Jnesselr/Vending-Machine/KiCad/MainBoard/Snack Machine.kicad_pcb

## KiCad design KiCad/MainBoard/Snack Machine.kicad_pcb (2020-05-02)

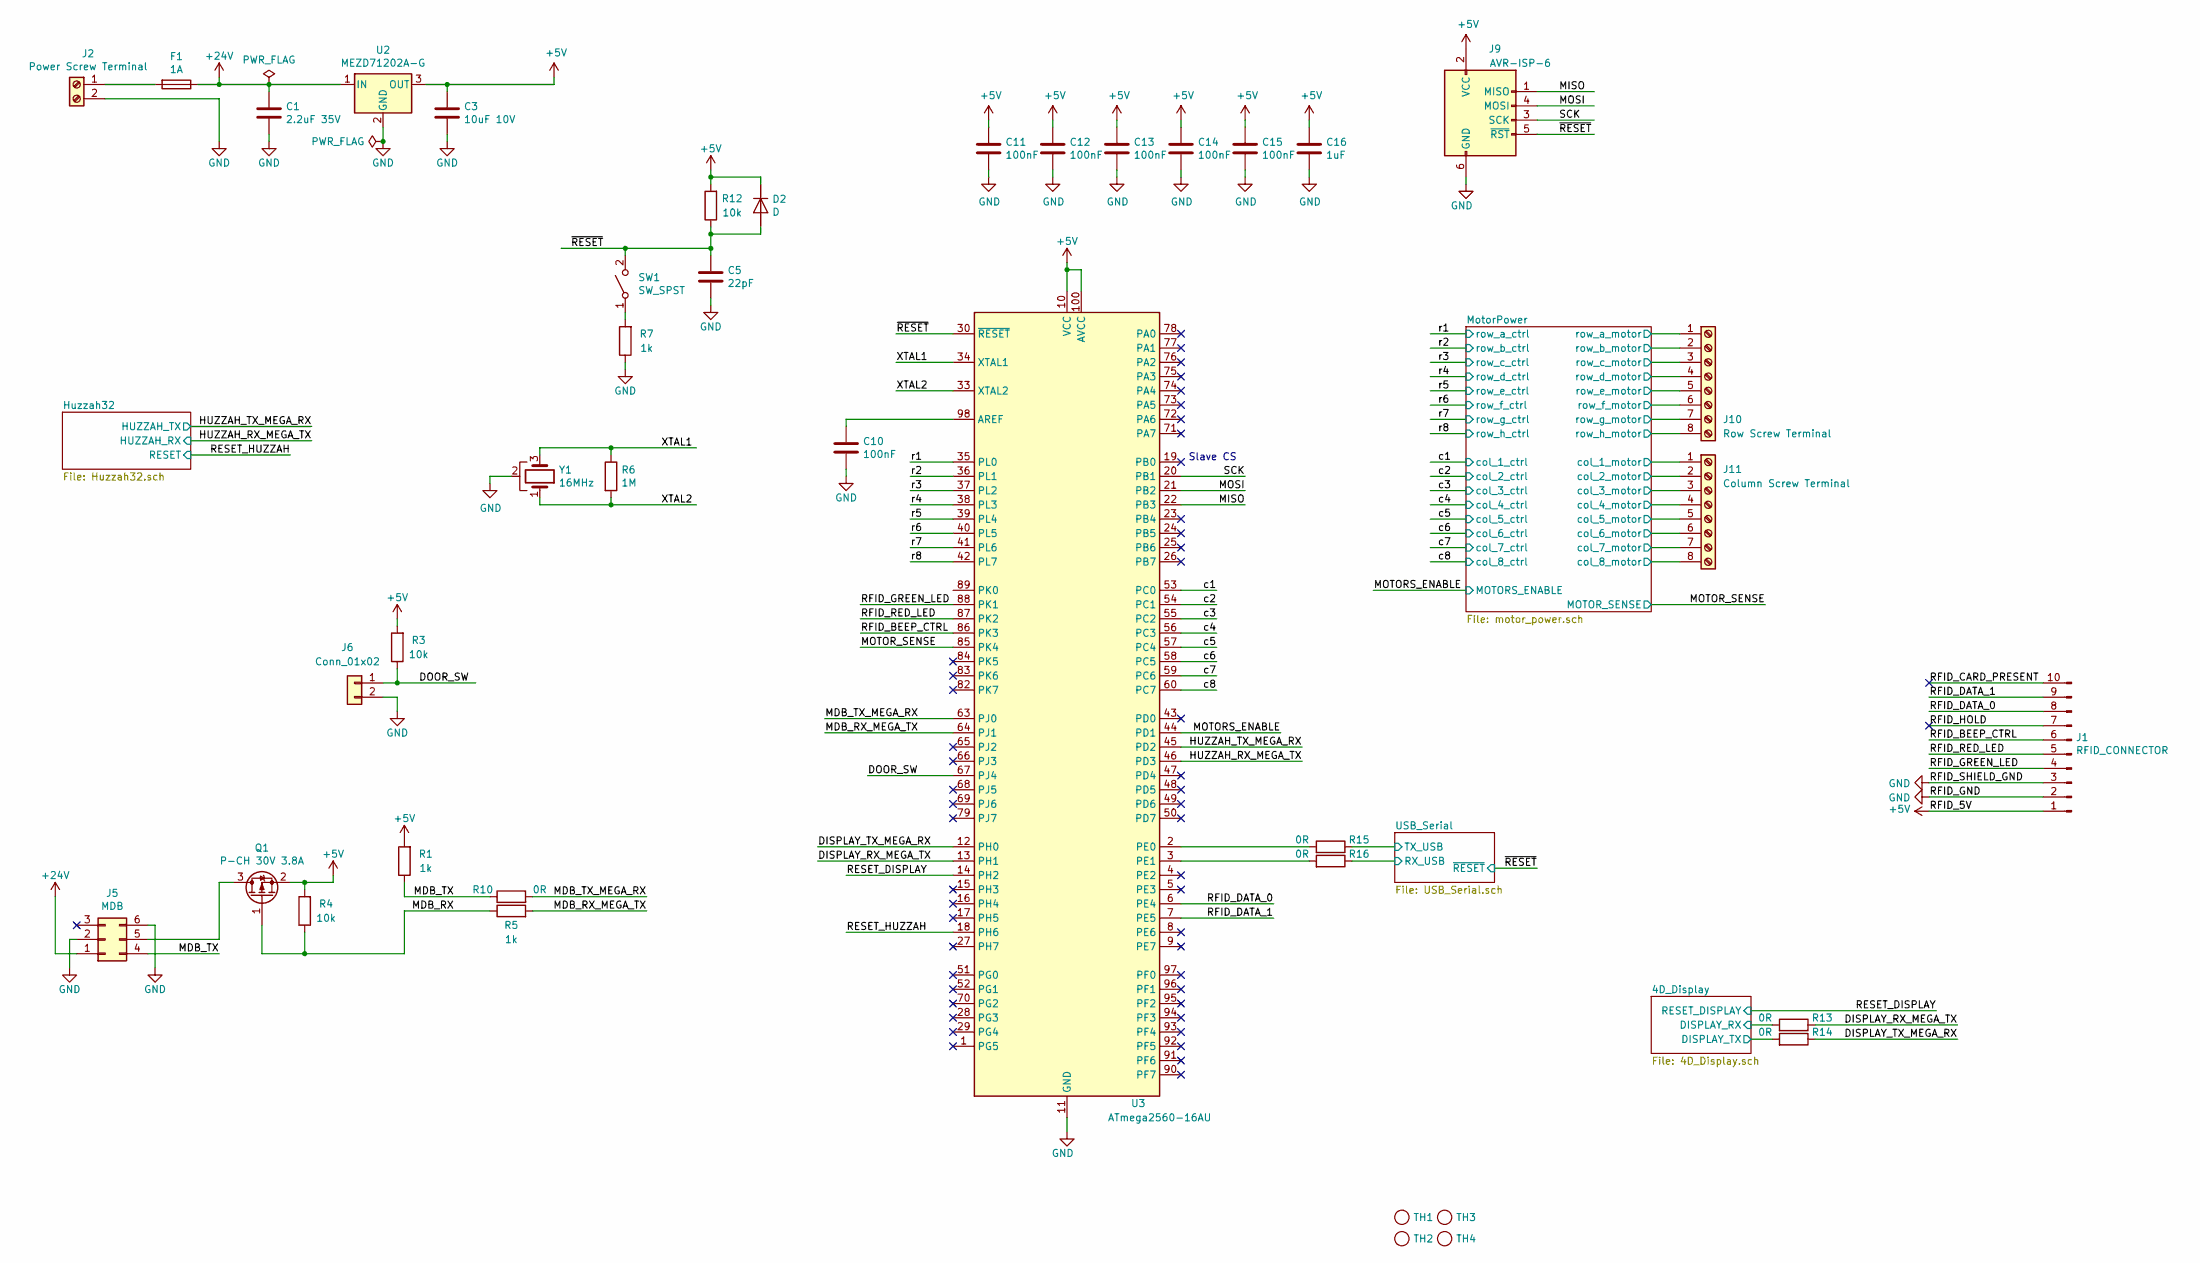
[picture p1: schematic Snack Machine.sch]

Parts:
C1: 2.2uF 35V; C_0805_2012Metric_Pad1.15x1.40mm_HandSolder; Part Number C2012JB1V225K125AB
C3: 10uF 10V; C_0603_1608Metric_Pad1.05x0.95mm_HandSolder; Part Number 0603ZD106KAT2A
C5: 22pF; C_0603_1608Metric_Pad1.05x0.95mm_HandSolder; Part Number C0603C220J1GACTU
C10, C11, C12, C13, C14, C15: 100nF; C_0603_1608Metric_Pad1.05x0.95mm_HandSolder; Part Number CC0603KRX7R9BB104
C16: 1uF; C_0603_1608Metric_Pad1.05x0.95mm_HandSolder; Part Number C1608X7R1A105K080AC
D2: D; D_1206_3216Metric_Pad1.42x1.75mm_HandSolder; Part Number CD1206-S01575
F1: 1A; Keystone_3544-2; Part Number 3544-2
J1: RFID_CONNECTOR; CONN_HEADER_VERT_10POS_2.54MM; Part Number 0705430009
J2: Power Screw Terminal; TerminalBlock_Phoenix_PT-1,5-2-5.0-H_1x02_P5.00mm_Horizontal; Part Number OQ0254500000G
J5: MDB; Molex_Mini-Fit_Jr_5566-06A_2x03_P4.20mm_Vertical; Part Number 0039290063
J6: Conn_01x02; CONN_HEADER_VERT_2POS_2.54MM; Part Number 0705430106
J9: AVR-ISP-6; PinHeader_2x03_P2.54mm_Vertical
J10: Row Screw Terminal; TerminalBlock_Phoenix_PT-1,5-8-5.0-H_1x08_P5.00mm_Horizontal; Part Number OQ0854500000G
J11: Column Screw Terminal; TerminalBlock_Phoenix_PT-1,5-8-5.0-H_1x08_P5.00mm_Horizontal; Part Number OQ0854500000G
Q1: P-CH 30V 3.8A; SOT-23_Handsoldering_Lite; Part Number DMP3099L-7
R1, R5, R7: 1k; R_0603_1608Metric_Pad1.05x0.95mm_HandSolder; Part Number RC0603FR-071KL
R3, R4, R12: 10k; R_0603_1608Metric_Pad1.05x0.95mm_HandSolder; Part Number RC0603FR-0710KL
R6: 1M; R_0603_1608Metric_Pad1.05x0.95mm_HandSolder; Part Number RC0603FR-071ML
R10, R13, R14, R15, R16: 0R; R_0603_1608Metric_Pad1.05x0.95mm_HandSolder; Part Number RC0603JR-070RL
SW1: SW_SPST; SW_SPST_FSMSM; Part Number FSMSM
TH1, TH2, TH3, TH4: tooling_hole; tooling_hole_2.55
U2: MEZD71202A-G; mEZD71201A
U3: ATmega2560-16AU; TQFP-100_14x14mm_P0.5mm
Y1: 16MHz; Resonator_SMD_ECS-CR2-16.00-B-TR; Part Number ECS-CR2-16.00-B-TR

Connections:
+5V: C3.1, C11.1, C12.1, C13.1, C14.1, C15.1, C16.1, D2.1 (K), J1.1, J9.2 (VCC), Q1.2 (S), R1.2, R3.2, R4.2, R12.2, U2.3 (OUT), U3.10 (VCC), U3.31 (VCC), U3.61 (VCC), U3.80 (VCC), U3.100 (AVCC); also elsewhere on the board
+24V: C1.1, F1.1, J5.1, U2.1 (IN); also elsewhere on the board
/4D_Display/DISPLAY_RX: R13.2; also elsewhere on the board
/4D_Display/DISPLAY_TX: R14.2; also elsewhere on the board
/DISPLAY_RX_MEGA_TX: R13.1, U3.13 (PH1)
/DISPLAY_TX_MEGA_RX: R14.1, U3.12 (PH0)
/DOOR_SW: J6.1, R3.1, U3.67 (PJ4)
/HUZZAH_RX_MEGA_TX: U3.46 (PD3); also elsewhere on the board
/HUZZAH_TX_MEGA_RX: U3.45 (PD2); also elsewhere on the board
/MDB_RX: Q1.1 (G), R4.1, R5.1
/MDB_RX_MEGA_TX: R5.2, U3.64 (PJ1)
/MDB_TX: J5.4, R1.1, R10.1
/MDB_TX_MEGA_RX: R10.2, U3.63 (PJ0)
/MISO: J9.1 (MISO), U3.22 (PB3)
/MOSI: J9.4 (MOSI), U3.21 (PB2)
/MOTORS_ENABLE: U3.44 (PD1); also elsewhere on the board
/MOTOR_SENSE: U3.85 (PK4); also elsewhere on the board
/MotorPower/col_1_motor: J11.1; also elsewhere on the board
/MotorPower/col_2_motor: J11.2; also elsewhere on the board
/MotorPower/col_3_motor: J11.3; also elsewhere on the board
/MotorPower/col_4_motor: J11.4; also elsewhere on the board
/MotorPower/col_5_motor: J11.5; also elsewhere on the board
/MotorPower/col_6_motor: J11.6; also elsewhere on the board
/MotorPower/col_7_motor: J11.7; also elsewhere on the board
/MotorPower/col_8_motor: J11.8; also elsewhere on the board
/MotorPower/row_a_motor: J10.1; also elsewhere on the board
/MotorPower/row_b_motor: J10.2; also elsewhere on the board
/MotorPower/row_c_motor: J10.3; also elsewhere on the board
/MotorPower/row_d_motor: J10.4; also elsewhere on the board
/MotorPower/row_e_motor: J10.5; also elsewhere on the board
/MotorPower/row_f_motor: J10.6; also elsewhere on the board
/MotorPower/row_g_motor: J10.7; also elsewhere on the board
/MotorPower/row_h_motor: J10.8; also elsewhere on the board
/RESET_DISPLAY: U3.14 (PH2); also elsewhere on the board
/RESET_HUZZAH: U3.18 (PH6); also elsewhere on the board
/RFID_BEEP_CTRL: J1.6, U3.86 (PK3)
/RFID_CARD_PRESENT: J1.10
/RFID_DATA_0: J1.8, U3.6 (PE4)
/RFID_DATA_1: J1.9, U3.7 (PE5)
/RFID_GREEN_LED: J1.4, U3.88 (PK1)
/RFID_HOLD: J1.7
/RFID_RED_LED: J1.5, U3.87 (PK2)
/SCK: J9.3 (SCK), U3.20 (PB1)
/USB_Serial/RX_USB: R16.1; also elsewhere on the board
/USB_Serial/TX_USB: R15.1; also elsewhere on the board
/XTAL1: R6.1, U3.34 (XTAL1), Y1.3
/XTAL2: R6.2, U3.33 (XTAL2), Y1.1
/c1: U3.53 (PC0); also elsewhere on the board
/c2: U3.54 (PC1); also elsewhere on the board
/c3: U3.55 (PC2); also elsewhere on the board
/c4: U3.56 (PC3); also elsewhere on the board
/c5: U3.57 (PC4); also elsewhere on the board
/c6: U3.58 (PC5); also elsewhere on the board
/c7: U3.59 (PC6); also elsewhere on the board
/c8: U3.60 (PC7); also elsewhere on the board
/r1: U3.35 (PL0); also elsewhere on the board
/r2: U3.36 (PL1); also elsewhere on the board
/r3: U3.37 (PL2); also elsewhere on the board
/r4: U3.38 (PL3); also elsewhere on the board
/r5: U3.39 (PL4); also elsewhere on the board
/r6: U3.40 (PL5); also elsewhere on the board
/r7: U3.41 (PL6); also elsewhere on the board
/r8: U3.42 (PL7); also elsewhere on the board
/~RESET: C5.1, D2.2 (A), J9.5 (~RST), R12.1, SW1.2 (B), U3.30 (~RESET); also elsewhere on the board
GND: C1.2, C3.2, C5.2, C10.2, C11.2, C12.2, C13.2, C14.2, C15.2, C16.2, J1.2, J1.3, J2.2, J5.2, J5.6, J6.2, J9.6 (GND), R7.1, U2.2 (GND), U3.11 (GND), U3.32 (GND), U3.62 (GND), U3.81 (GND), U3.99 (GND), Y1.2; also elsewhere on the board
unnamed: C10.1, U3.98 (AREF)
unnamed: F1.2, J2.1
unnamed: J5.5, Q1.3 (D)
unnamed: R7.2, SW1.1 (A)
unnamed: R15.2, U3.2 (PE0)
unnamed: R16.2, U3.3 (PE1)

Notes on the sheet:
Slave CS

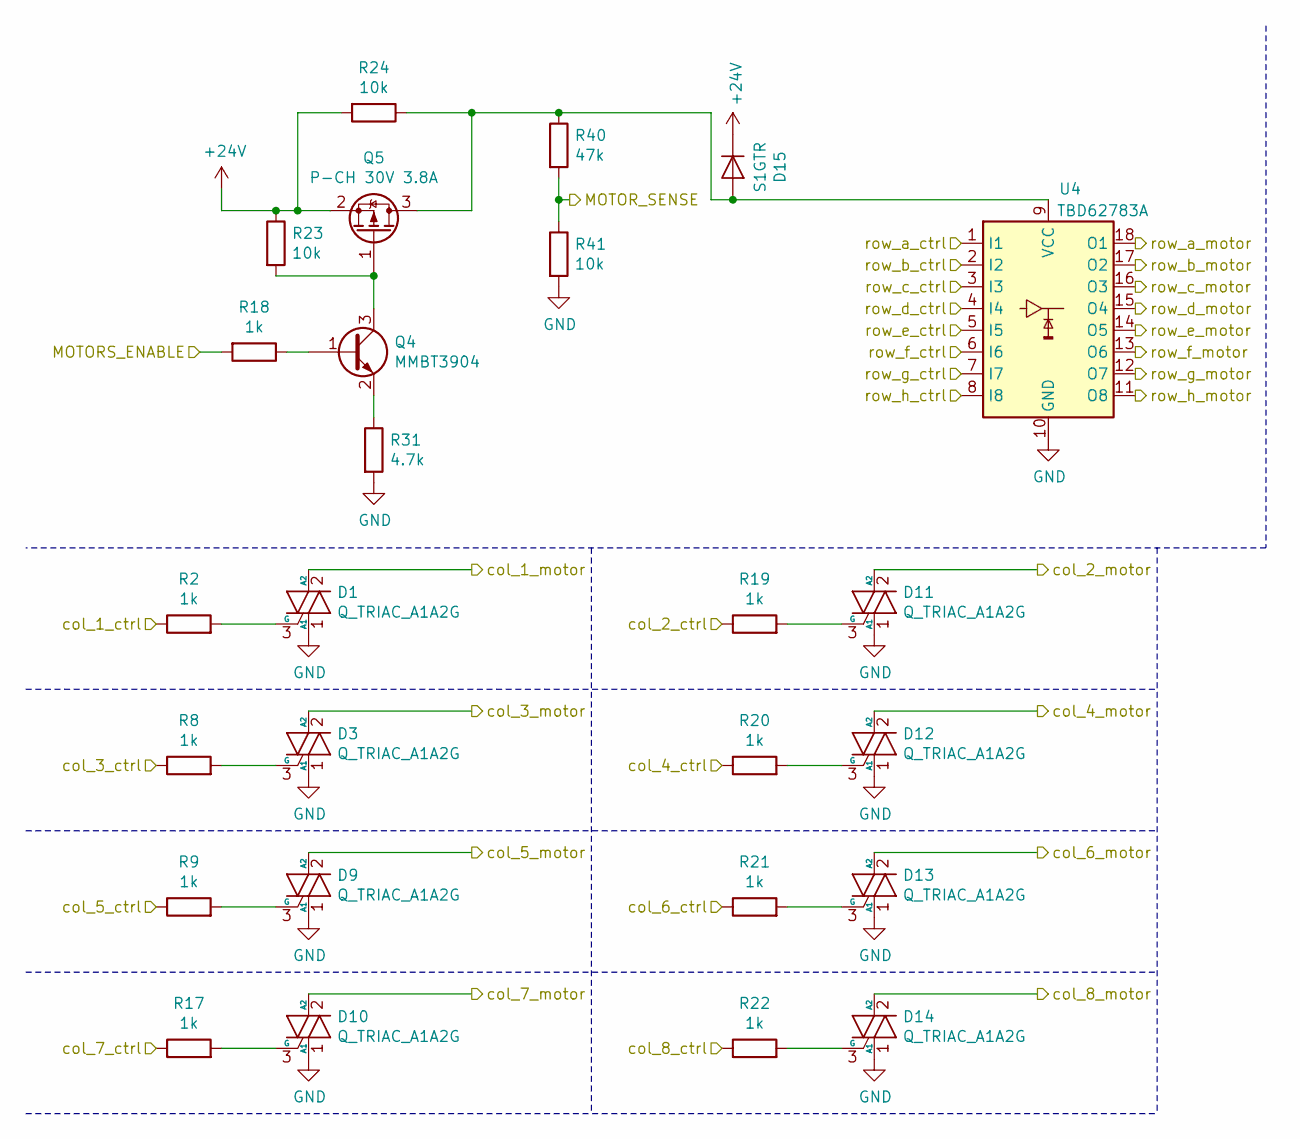
[picture p2: schematic motor_power.sch]

Parts:
D1, D3, D9, D10, D11, D12, D13, D14: Q_TRIAC_A1A2G; SOT-223-3_TabPin2; Part Number Z0103MN,135
D15: S1GTR; D_SMA_Handsoldering; Part Number S1GTR
Q4: MMBT3904; SOT-23_Handsoldering_Lite; Part Number MMBT3904-TP
Q5: P-CH 30V 3.8A; SOT-23_Handsoldering_Lite; Part Number DMP3099L-7
R2, R8, R9, R17, R18, R19, R20, R21, R22: 1k; R_0603_1608Metric_Pad1.05x0.95mm_HandSolder; Part Number RC0603FR-071KL
R23, R24, R41: 10k; R_0603_1608Metric_Pad1.05x0.95mm_HandSolder; Part Number RC0603FR-0710KL
R31: 4.7k; R_0603_1608Metric_Pad1.05x0.95mm_HandSolder; Part Number RC0603FR-074K7L
R40: 47k; R_0603_1608Metric_Pad1.05x0.95mm_HandSolder; Part Number RC0603FR-0747KL
U4: TBD62783A; SSOP-18_4.4x6.5mm_P0.65mm; Part Number TBD62783AFNG,EL

Connections:
+24V: D15.1 (K), Q5.2 (S), R23.1, R24.2; also elsewhere on the board
/MOTORS_ENABLE: R18.2; also elsewhere on the board
/MOTOR_SENSE: R40.2, R41.1; also elsewhere on the board
/MotorPower/col_1_motor: D1.2 (A2); also elsewhere on the board
/MotorPower/col_2_motor: D11.2 (A2); also elsewhere on the board
/MotorPower/col_3_motor: D3.2 (A2); also elsewhere on the board
/MotorPower/col_4_motor: D12.2 (A2); also elsewhere on the board
/MotorPower/col_5_motor: D9.2 (A2); also elsewhere on the board
/MotorPower/col_6_motor: D13.2 (A2); also elsewhere on the board
/MotorPower/col_7_motor: D10.2 (A2); also elsewhere on the board
/MotorPower/col_8_motor: D14.2 (A2); also elsewhere on the board
/MotorPower/row_a_motor: U4.18 (O1); also elsewhere on the board
/MotorPower/row_b_motor: U4.17 (O2); also elsewhere on the board
/MotorPower/row_c_motor: U4.16 (O3); also elsewhere on the board
/MotorPower/row_d_motor: U4.15 (O4); also elsewhere on the board
/MotorPower/row_e_motor: U4.14 (O5); also elsewhere on the board
/MotorPower/row_f_motor: U4.13 (O6); also elsewhere on the board
/MotorPower/row_g_motor: U4.12 (O7); also elsewhere on the board
/MotorPower/row_h_motor: U4.11 (O8); also elsewhere on the board
/c1: R2.1; also elsewhere on the board
/c2: R19.1; also elsewhere on the board
/c3: R8.1; also elsewhere on the board
/c4: R20.1; also elsewhere on the board
/c5: R9.1; also elsewhere on the board
/c6: R21.1; also elsewhere on the board
/c7: R17.1; also elsewhere on the board
/c8: R22.1; also elsewhere on the board
/r1: U4.1 (I1); also elsewhere on the board
/r2: U4.2 (I2); also elsewhere on the board
/r3: U4.3 (I3); also elsewhere on the board
/r4: U4.4 (I4); also elsewhere on the board
/r5: U4.5 (I5); also elsewhere on the board
/r6: U4.6 (I6); also elsewhere on the board
/r7: U4.7 (I7); also elsewhere on the board
/r8: U4.8 (I8); also elsewhere on the board
GND: D1.1 (A1), D3.1 (A1), D9.1 (A1), D10.1 (A1), D11.1 (A1), D12.1 (A1), D13.1 (A1), D14.1 (A1), R31.2, R41.2, U4.10 (GND); also elsewhere on the board
unnamed: D1.3 (G), R2.2
unnamed: D3.3 (G), R8.2
unnamed: D9.3 (G), R9.2
unnamed: D10.3 (G), R17.2
unnamed: D11.3 (G), R19.2
unnamed: D12.3 (G), R20.2
unnamed: D13.3 (G), R21.2
unnamed: D14.3 (G), R22.2
unnamed: D15.2 (A), Q5.3 (D), R24.1, R40.1, U4.9 (VCC)
unnamed: Q4.1 (B), R18.1
unnamed: Q4.2 (E), R31.1
unnamed: Q4.3 (C), Q5.1 (G), R23.2

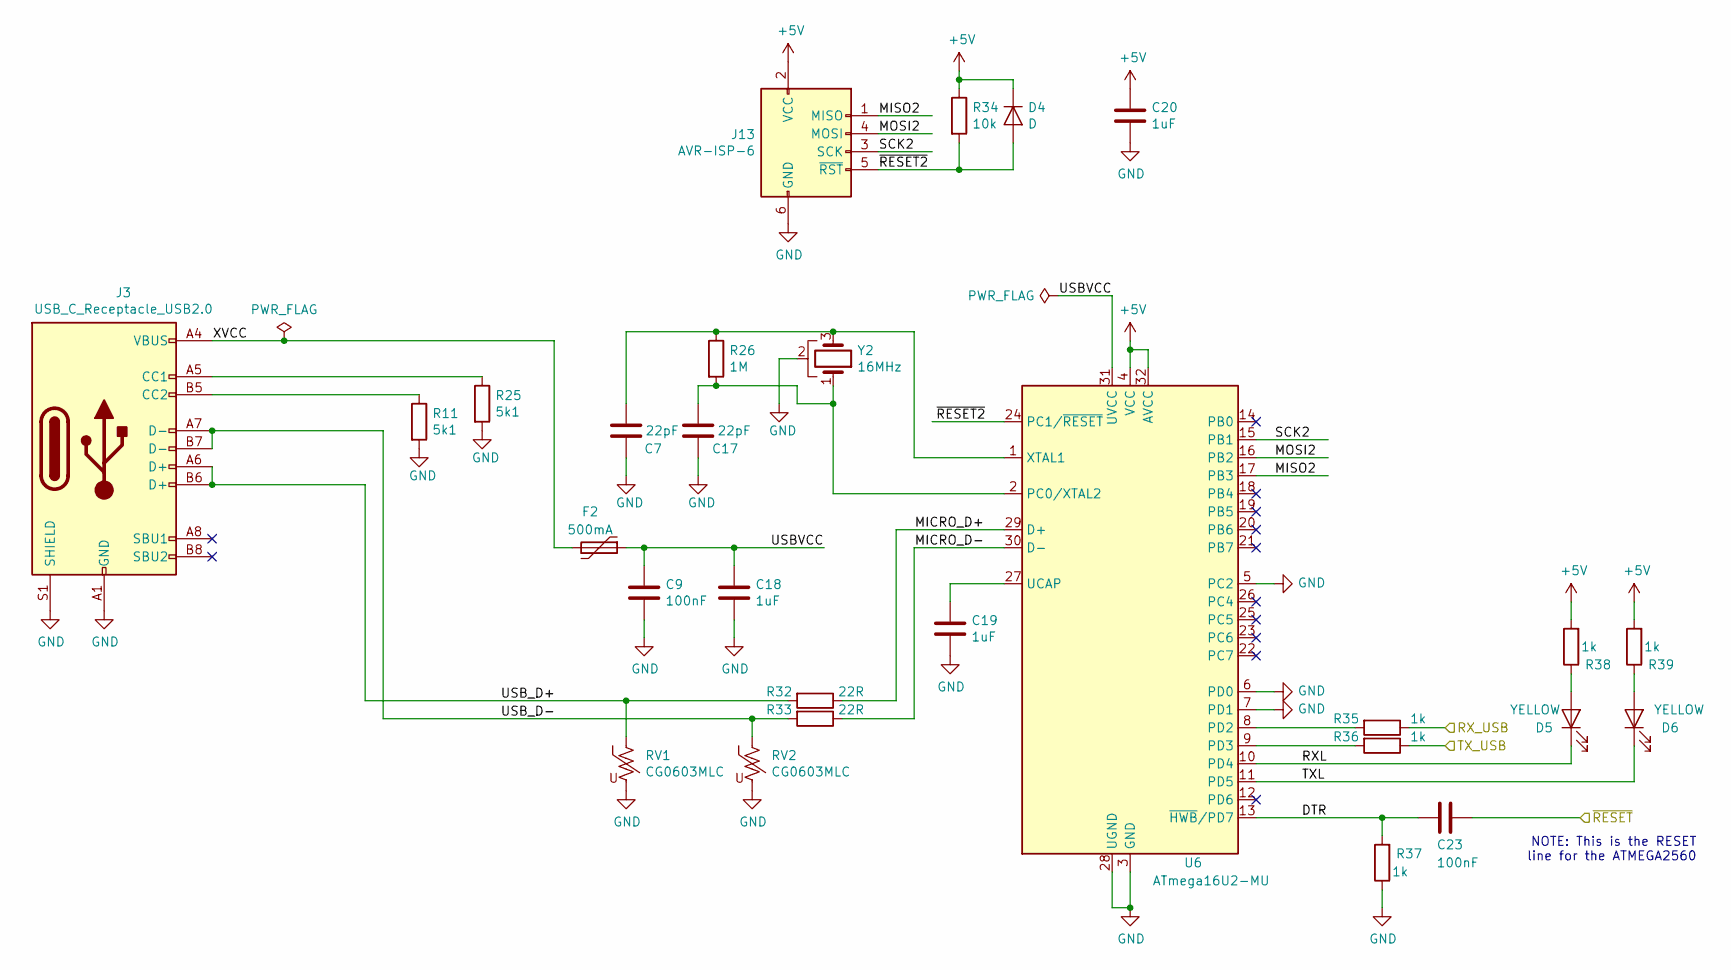
[picture p3: schematic USB_Serial.sch]

Parts:
C7, C17: 22pF; C_0603_1608Metric_Pad1.05x0.95mm_HandSolder; Part Number C0603C220J1GACTU
C9, C23: 100nF; C_0603_1608Metric_Pad1.05x0.95mm_HandSolder; Part Number CC0603KRX7R9BB104
C18, C19, C20: 1uF; C_0603_1608Metric_Pad1.05x0.95mm_HandSolder; Part Number C1608X7R1A105K080AC
D4: D; D_1206_3216Metric_Pad1.42x1.75mm_HandSolder; Part Number CD1206-S01575
D5, D6: YELLOW; LED_0603_1608Metric_Pad1.05x0.95mm_HandSolder; Part Number 150060YS75000
F2: 500mA; MF-MSMF050-2; Part Number MF-MSMF050-2
J3: USB_C_Receptacle_USB2.0; USB_C_Receptacle_HRO_TYPE-C-31-M-12; Part Number DX07S016JA1R1500
J13: AVR-ISP-6; PinHeader_2x03_P2.54mm_Vertical
R11, R25: 5k1; R_0603_1608Metric_Pad1.05x0.95mm_HandSolder; Part Number RC0603FR-075K1L
R26: 1M; R_0603_1608Metric_Pad1.05x0.95mm_HandSolder; Part Number RC0603FR-071ML
R32, R33: 22R; R_0603_1608Metric_Pad1.05x0.95mm_HandSolder; Part Number RC0603FR-0722RL
R34: 10k; R_0603_1608Metric_Pad1.05x0.95mm_HandSolder; Part Number RC0603FR-0710KL
R35, R36, R37, R38, R39: 1k; R_0603_1608Metric_Pad1.05x0.95mm_HandSolder; Part Number RC0603FR-071KL
RV1, RV2: CG0603MLC; R_0603_1608Metric_Pad1.05x0.95mm_HandSolder; Part Number CG0603MLC-05E
U6: ATmega16U2-MU; QFN-32-1EP_5x5mm_P0.5mm_EP3.1x3.1mm
Y2: 16MHz; Resonator_SMD_ECS-CR2-16.00-B-TR; Part Number ECS-CR2-16.00-B-TR

Connections:
+5V: C20.1, D4.1 (K), J13.2 (VCC), R34.1, R38.2, R39.2, U6.4 (VCC), U6.32 (AVCC); also elsewhere on the board
/USB_Serial/DTR: C23.2, R37.2, U6.13 (~HWB~/PD7)
/USB_Serial/MICRO_D+: R32.1, U6.29 (D+)
/USB_Serial/MICRO_D-: R33.1, U6.30 (D-)
/USB_Serial/MISO2: J13.1 (MISO), U6.17 (PB3)
/USB_Serial/MOSI2: J13.4 (MOSI), U6.16 (PB2)
/USB_Serial/RXL: D5.1 (K), U6.10 (PD4)
/USB_Serial/RX_USB: R35.1; also elsewhere on the board
/USB_Serial/SCK2: J13.3 (SCK), U6.15 (PB1)
/USB_Serial/TXL: D6.1 (K), U6.11 (PD5)
/USB_Serial/TX_USB: R36.1; also elsewhere on the board
/USB_Serial/USBVCC: C9.1, C18.1, F2.1, U6.31 (UVCC)
/USB_Serial/USB_D+: J3.A6 (D+), J3.B6 (D+), R32.2, RV1.1
/USB_Serial/USB_D-: J3.A7 (D-), J3.B7 (D-), R33.2, RV2.1
/USB_Serial/XVCC: F2.2, J3.A4 (VBUS), J3.B4 (VBUS)
/USB_Serial/~RESET2: D4.2 (A), J13.5 (~RST), R34.2, U6.24 (PC1/~RESET)
/~RESET: C23.1; also elsewhere on the board
GND: C7.1, C9.2, C17.1, C18.2, C19.2, C20.2, J3.A1 (GND), J3.B1 (GND), J3.S1 (SHIELD), J13.6 (GND), R11.2, R25.2, R37.1, RV1.2, RV2.2, U6.3 (GND), U6.5 (PC2), U6.6 (PD0), U6.7 (PD1), U6.28 (UGND), U6.33 (GND), Y2.2; also elsewhere on the board
unnamed: C7.2, R26.1, U6.1 (XTAL1), Y2.3
unnamed: C17.2, R26.2, U6.2 (PC0/XTAL2), Y2.1
unnamed: C19.1, U6.27 (UCAP)
unnamed: D5.2 (A), R38.1
unnamed: D6.2 (A), R39.1
unnamed: J3.A5 (CC1), R25.1
unnamed: J3.B5 (CC2), R11.1
unnamed: R35.2, U6.8 (PD2)
unnamed: R36.2, U6.9 (PD3)

Notes on the sheet:
NOTE: This is the RESET line for the ATMEGA2560

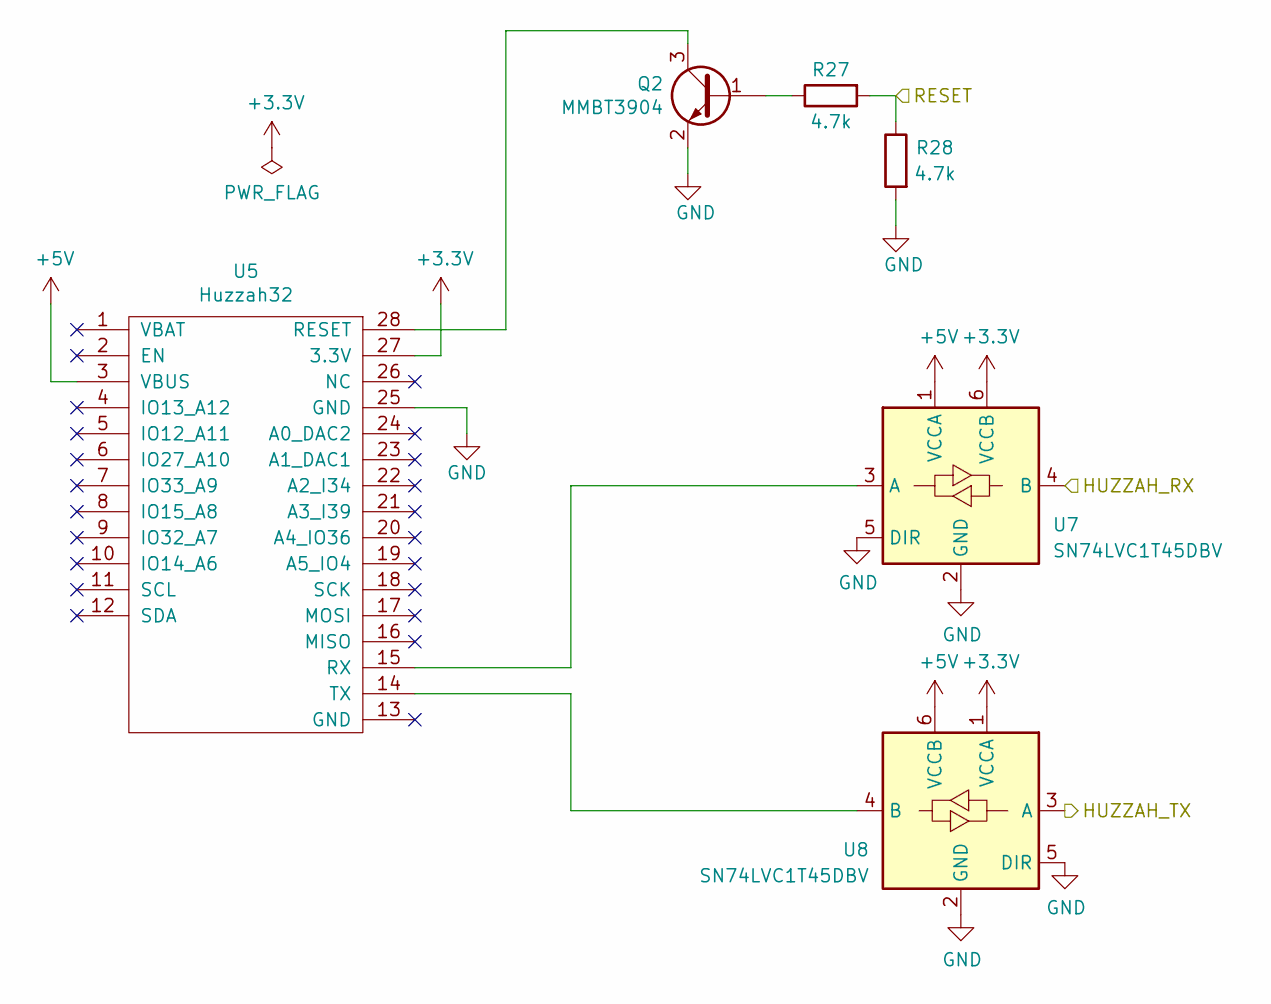
[picture p4: schematic Huzzah32.sch]

Parts:
Q2: MMBT3904; SOT-23_Handsoldering_Lite; Part Number MMBT3904-TP
R27, R28: 4.7k; R_0603_1608Metric_Pad1.05x0.95mm_HandSolder; Part Number RC0603FR-074K7L
U5: Huzzah32; HUZZAH32
U7, U8: SN74LVC1T45DBV; SOT-23-6; Part Number SN74LVC1T45DBV

Connections:
+3V3: U5.27 (3.3V), U7.6 (VCCB), U8.1 (VCCA)
+5V: U5.3 (VBUS), U7.1 (VCCA), U8.6 (VCCB); also elsewhere on the board
/HUZZAH_RX_MEGA_TX: U7.4 (B); also elsewhere on the board
/HUZZAH_TX_MEGA_RX: U8.3 (A); also elsewhere on the board
/RESET_HUZZAH: R27.2, R28.1; also elsewhere on the board
GND: Q2.2 (E), R28.2, U5.25 (GND), U7.2 (GND), U7.5 (DIR), U8.2 (GND), U8.5 (DIR); also elsewhere on the board
unnamed: Q2.1 (B), R27.1
unnamed: Q2.3 (C), U5.28 (RESET)
unnamed: U5.14 (TX), U8.4 (B)
unnamed: U5.15 (RX), U7.3 (A)

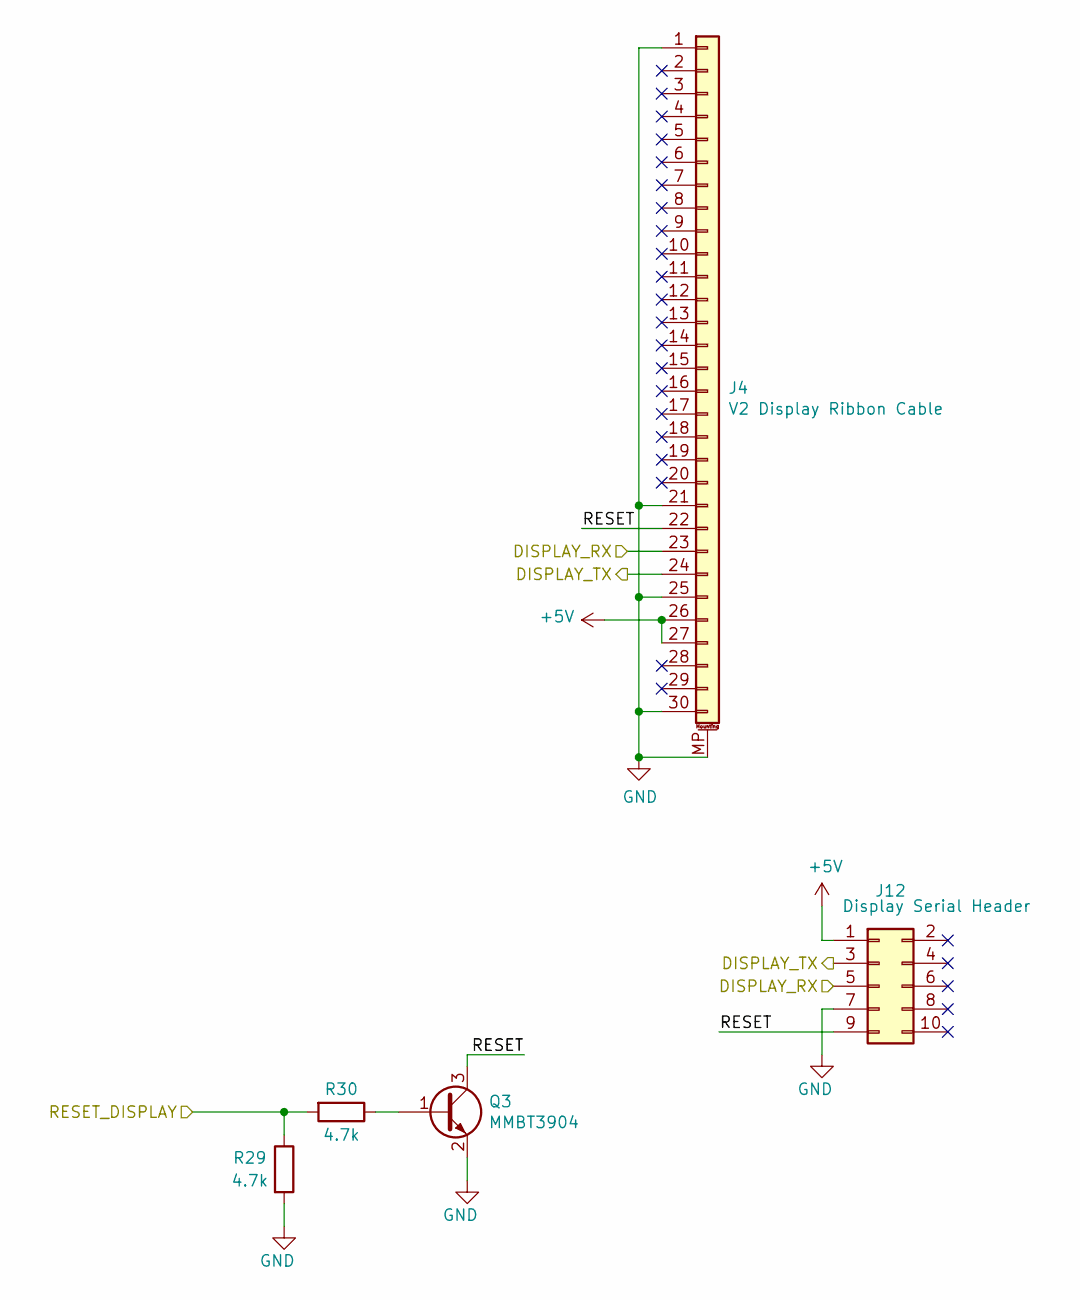
[picture p5: schematic 4D_Display.sch]

Parts:
J4: V2 Display Ribbon Cable; FPC30; Part Number 3-1734839-0
J12: Display Serial Header; PinHeader_2x05_P2.54mm_Vertical; Part Number 5103308-1
Q3: MMBT3904; SOT-23_Handsoldering_Lite; Part Number MMBT3904-TP
R29, R30: 4.7k; R_0603_1608Metric_Pad1.05x0.95mm_HandSolder; Part Number RC0603FR-074K7L

Connections:
+5V: J4.26, J4.27, J12.1; also elsewhere on the board
/4D_Display/DISPLAY_RX: J4.23, J12.5; also elsewhere on the board
/4D_Display/DISPLAY_TX: J4.24, J12.3; also elsewhere on the board
/4D_Display/RESET: J4.22, J12.9, Q3.3 (C)
/RESET_DISPLAY: R29.1, R30.2; also elsewhere on the board
GND: J4.1, J4.21, J4.25, J4.30, J4.MP (MountPin), J12.7, Q3.2 (E), R29.2; also elsewhere on the board
unnamed: Q3.1 (B), R30.1

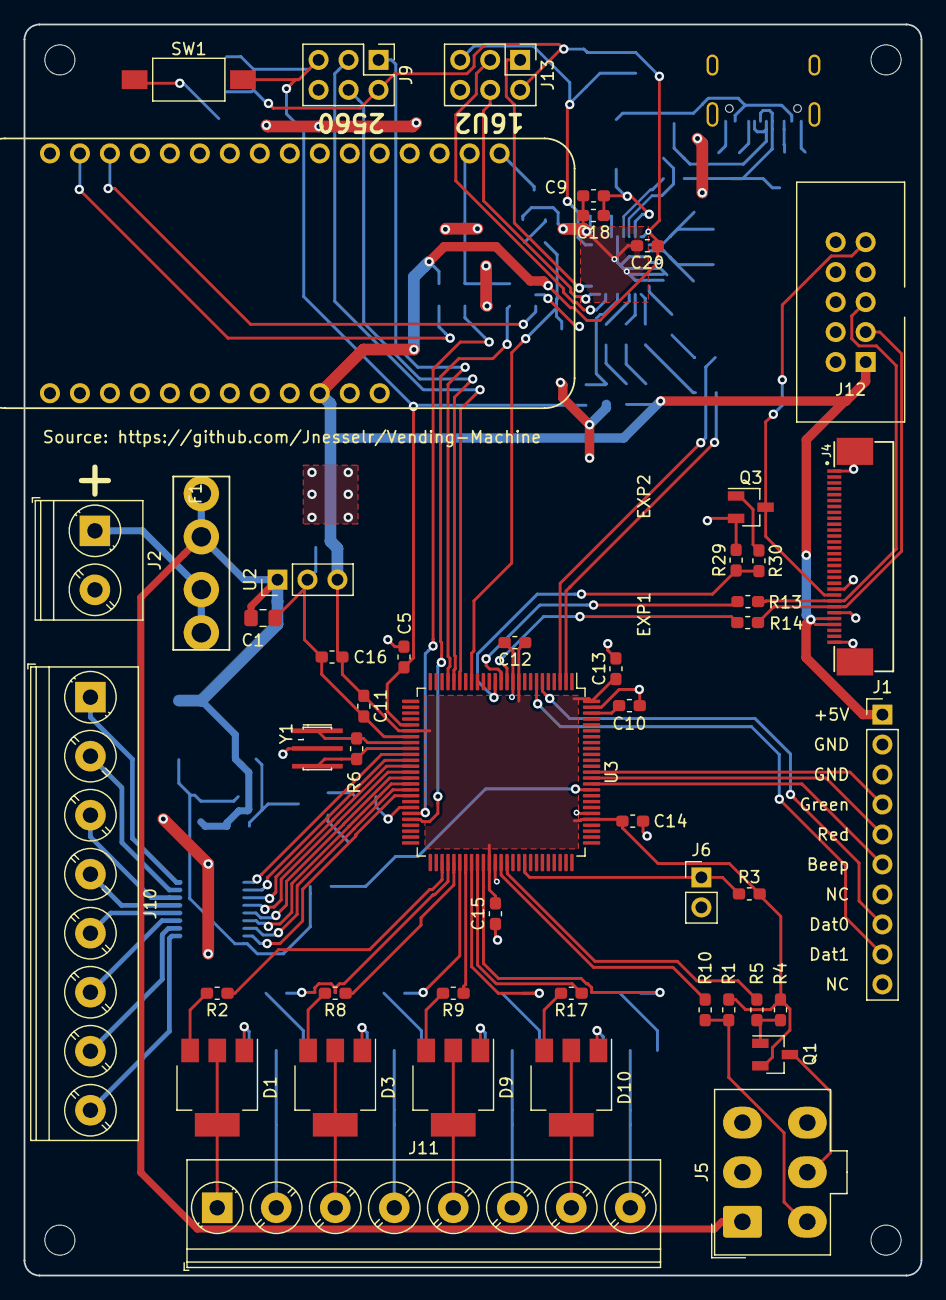
[picture p6: board Snack Machine.kicad_pcb from above]

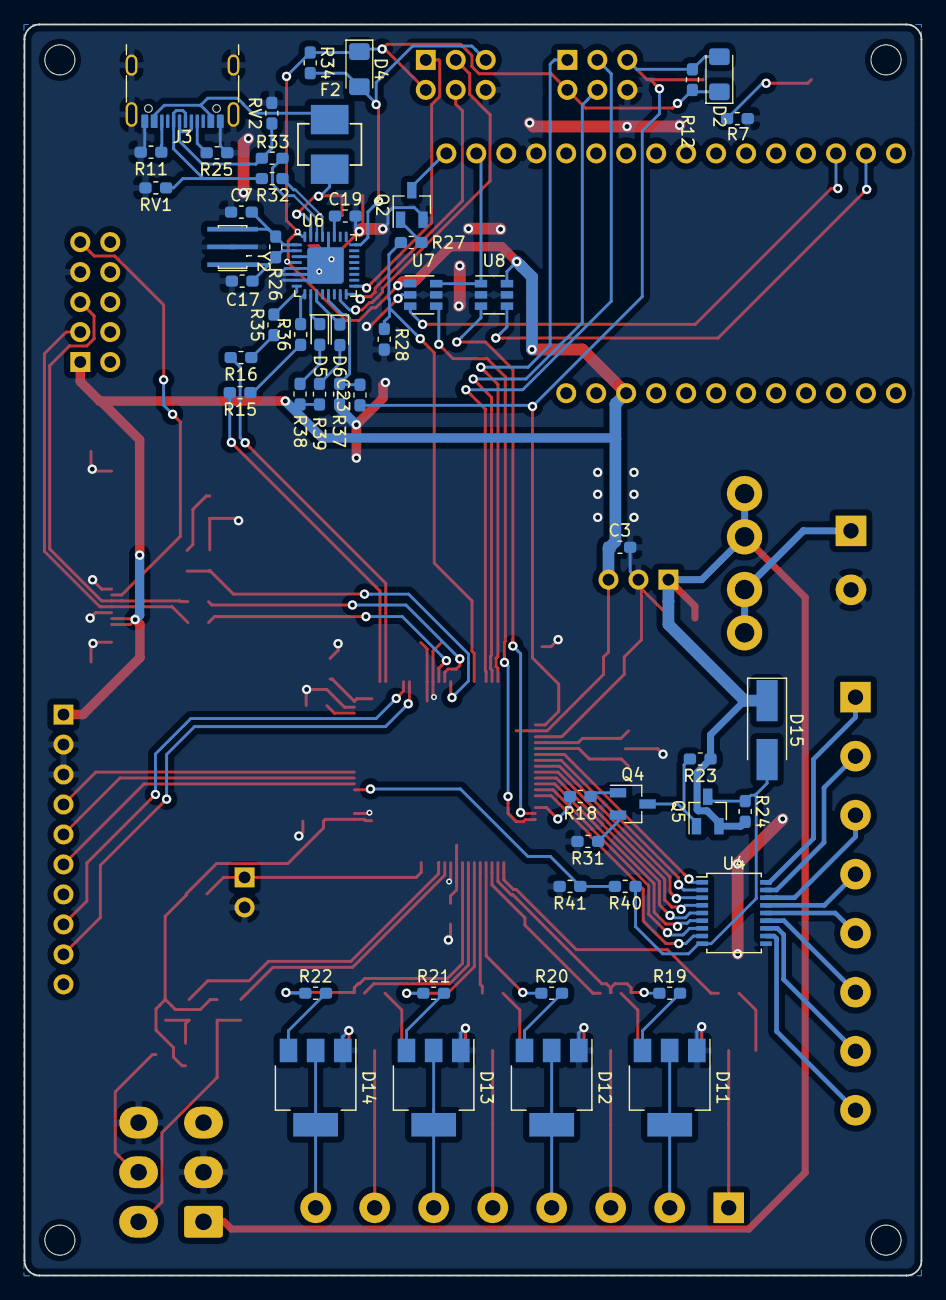
[picture p7: board Snack Machine.kicad_pcb from below]

Board: 2 copper layers, 76.0 x 106.0 mm, 105 parts (53 on the bottom side), 110 nets.
