Jnesselr/Vending-Machine/snack-machine-firmware/src/motors.h

#pragma once

enum class MotorSystemState {
  UNKNOWN,  // Unknown, just powered up
  SCANNING, // Scanning on startup
  IDLE      // Ready to vend!
};

enum class MotorState {
  NONE_SELECTED,  // No motor selected
  SCAN_SELECTED,  // Motor selected for scanning
  VEND_START,     // Starting vend
  VEND_WAIT       // Waiting for vend to finish
};

typedef void (*MotorSystemStateCallback)(MotorSystemState oldState, MotorSystemState newState);
typedef void (*MotorStateCallback)(MotorState oldState, MotorState newState);
typedef void (*ItemVendedCallback)(uint8_t row, uint8_t col);
typedef void (*MotorAvailableCallback)(uint8_t row, uint8_t col, bool available);

class Motors {
  public:
    static void setup();
    static void loop();

    static bool rowExists(int row);
    static bool exists(int row, int col);
    static void vend(int row, int col);
    static void off();

    // Callbacks
    static MotorSystemStateCallback onSystemStateChanged;
    static MotorStateCallback onMotorStateChanged;
    static ItemVendedCallback onItemVended;
    static MotorAvailableCallback onMotorAvailability;
  private:
    static bool valid(int row, int col);

    static void updateSystemState(MotorSystemState motorSystemState);
    static void updateMotorState(MotorState motorState);

    static void handleInitialScan();

    static MotorSystemState systemState;
    static MotorState motorState;

    static unsigned long lastStateChangeTime;
    static uint8_t motorsScanResult[8];
    static uint8_t selectedRow;
    static uint8_t selectedCol;

    static const int MOTORS_ENABLE = 20;
    static const int MOTORS_SENSE = PIN_A12;
    static const int ROW_1 = 49;
    static const int ROW_2 = 48;
    static const int ROW_3 = 47;
    static const int ROW_4 = 46;
    static const int ROW_5 = 45;
    static const int ROW_6 = 44;
    static const int ROW_7 = 43;
    static const int ROW_8 = 42;
    static const int COL_1 = 37;
    static const int COL_2 = 36;
    static const int COL_3 = 35;
    static const int COL_4 = 34;
    static const int COL_5 = 33;
    static const int COL_6 = 32;
    static const int COL_7 = 31;
    static const int COL_8 = 30;

    static const int ROWS[8];
    static const int COLS[8];
};
