Jnesselr/Vending-Machine/snack-machine-firmware/src/denhac/ProductManager.cpp

#ifdef VENDING_MAIN_BOARD

#include "denhac/ProductManager.h"

#include <EEPROM.h>

/**
 * Products are stored in EEPROM to handle network connectivity
 * issues and also mostly because we have nowhere else to put it
 * in an atmega2560 that's large enough.
 * 
 * Each product is stored in EEPROM like this:
 * uint8_t flag == 0xAA if product is there and valid
 * uint32_t id
 * char name[51]
 * uint32_t price
 * uint8_t stockAvailable
 * uint8_t stockInMachine
 * 
 * To find a particular product, it's start address is 62 * (8 * row + col)
 */

#define START_ADDRESS(row, col) 62 * (8 * row + col)

bool ProductManager::isValid(uint8_t row) {
  return isValid(row, 0) ||
        isValid(row, 1) ||
        isValid(row, 2) ||
        isValid(row, 3) ||
        isValid(row, 4) ||
        isValid(row, 5) ||
        isValid(row, 6) ||
        isValid(row, 7);
}

bool ProductManager::isValid(uint8_t row, uint8_t col) {
  uint16_t address = START_ADDRESS(row, col);

  return EEPROM.read(address) == 0xAA;
}

Product ProductManager::get(uint8_t row, uint8_t col) {
  uint16_t startAddress = START_ADDRESS(row, col);

  Product product;

  if(row < 0 || row > 8 || col < 0 || col > 8) {
    product.valid = false;
    return product;
  }

  if(!isValid(row, col)) {

    product.valid = false;
    return product;
  }

  product.id = readLong(startAddress + 1);
  readBytes(startAddress + 5, (uint8_t*) product.name, 51);
  product.price = readLong(startAddress + 56);
  product.stockAvailable = EEPROM.read(startAddress + 60);
  product.stockInMachine = EEPROM.read(startAddress + 61);
  product.row = row;
  product.col = col;
  product.valid = true;

  return product;
}

Product ProductManager::get(uint32_t productId) {
  Product product;

  for (uint8_t row = 0; row < 8; row++)
  {
    for (uint8_t col = 0; col < 8; col++)
    {
      if(isValid(row, col)) {
        product = get(row, col);
        if(product.id == productId) {
          return product;
        }
      }
    }
  }

  product.valid = false;

  return product;
}

void ProductManager::productUpdated(const Product& product) {
  uint16_t startAddress = START_ADDRESS(product.row, product.col);

  EEPROM.update(startAddress, 0xAA);
  writeLong(startAddress + 1, product.id);
  writeBytes(startAddress + 5, (uint8_t*) product.name, 51);
  writeLong(startAddress + 56, product.price);
  EEPROM.update(startAddress + 60, product.stockAvailable);
  EEPROM.update(startAddress + 61, product.stockInMachine);
}

void ProductManager::productRemoved(uint8_t row, uint8_t col) {
  uint16_t address = START_ADDRESS(row, col);

  // Invalidate the flag but don't overwite anything else to save
  // on EEPROM writes
  EEPROM.update(address, 0xFF);
}

void ProductManager::writeLong(uint16_t address, uint32_t value) {
  LongUnion unionValue;
  unionValue.longValue = value;

  writeBytes(address, unionValue.shortValues, sizeof(unionValue.shortValues));
}

/**
 * There's a potential race condition where the stock is physically
 * vended from the machine but we haven't gotten the website update yet.
 * In that time span, someone can try to vend more than the items we have
 * on hand, so we reduce stock manually and the update from the server should
 * match the reduced value so no EEPROM write needs to happen then.
 * 
 * We also reduce stock available which isn't guaranteed to be correct, but it
 * addresses the problem of an order being created, then quickly vended so the
 * product update hasn't adjusted stock available. From the user perspective,
 * this may look like a product that should be in stock is suddenly out of stock.
 * The next product update will address that though.
 */
void ProductManager::reduceStock(uint8_t row, uint8_t col) {
  uint16_t baseAddress = START_ADDRESS(row, col);

  uint8_t stockAvailable = EEPROM.read(baseAddress + 60);
  if(stockAvailable > 0) {
    EEPROM.write(baseAddress + 60, stockAvailable - 1); // Stock available
  }

  uint8_t stockInMachine = EEPROM.read(baseAddress + 61);
  if(stockInMachine > 0) {
    EEPROM.write(baseAddress + 61, stockInMachine - 1); // Stock in machine
  }
}

void ProductManager::writeBytes(
  uint16_t startAddress,
  uint8_t* value,
  size_t length) {
  for (size_t i = 0; i < length; i++)
  {
    EEPROM.update(startAddress + i, value[i]);
  }
}

uint32_t ProductManager::readLong(uint16_t address) {
  LongUnion unionValue;

  readBytes(address, unionValue.shortValues, sizeof(unionValue.shortValues));

  return unionValue.longValue;
}

void ProductManager::readBytes(
  uint16_t startAddress,
  uint8_t* value,
  size_t length) {
  for (size_t i = 0; i < length; i++)
  {
    value[i] = EEPROM.read(startAddress + i);
  }
}

#endif
