Jnesselr/Vending-Machine/(commit log)

2018-10-16 Improving motor high side schematic and making it more generalized
    [Snack Machine.sch, motor_power.sch]
2018-10-16 Switching to +5V from vcc
    [Snack Machine.sch, motor_power.sch]
2018-10-16 Annotating components
    [Snack Machine.sch, motor_power.sch]
2018-10-16 Adding USB Serial page and fixing address pins in INA219
    [Snack Machine.sch, USB_Serial.sch, motor_power.sch]
2018-10-16 Adding mdb interface ports
    [Snack Machine.sch]
2018-10-25 Updating changes
    [Snack Machine.sch, USB_Serial.sch]
2018-11-08 first stab at changes, added switching power supply, updated 2 ATmega footprints per KiCAD 5.0.2 update
    [Snack Machine.sch, USB_Serial.sch]
2018-11-12 Adding general outline for board
    [Snack Machine.kicad_pcb]
2018-11-19 Large number of changes, some cosmetic, most functional. Added analog current sense circuit, added switching power supply (24V->5V), added switch connector for sensing when door is open, added LCD128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
    [Snack Machine.sch, USB_Serial.sch, motor_power.sch]
2018-11-20 small tweaks
    [Snack Machine.sch, USB_Serial.sch]
2018-11-27 latest changes, not quite ready to be done, but making commit so we can continue to make layout changes while the schematic is being updated.
    [Snack Machine.sch]
2018-11-27 Updating annotations for all schematics
    [Snack Machine.sch, USB_Serial.sch, motor_power.sch]
2018-11-27 Fixing rescue issue with atmega2560 hopefully
    [Snack Machine.sch]
2018-11-27 latest changes, mostly test points and annotations
    [Snack Machine.sch, USB_Serial.sch]
2018-11-27 Updating components and footprints
    [Snack Machine.sch, USB_Serial.sch, motor_power.sch]
2018-11-27 changed all mosfets
    [Snack Machine.sch, motor_power.sch]
2018-11-27 Added input and output caps to 3.3V regulator
    [Snack Machine.sch]
2018-11-27 Adding ethernet sheet
    [Ethernet.sch, Snack Machine.sch, USB_Serial.sch, motor_power.sch]
2018-11-27 Adding connections to ethernet port on main board
    [Ethernet.sch, Snack Machine.sch, USB_Serial.sch, motor_power.sch]
2018-11-28 Annotating schematic
    [Ethernet.sch, Snack Machine.sch, USB_Serial.sch, motor_power.sch]
2018-11-28 Adding more footprints
    [Ethernet.sch, Snack Machine.sch, USB_Serial.sch, motor_power.sch]
2018-11-28 Found an SPST that works
    [Snack Machine.sch]
2018-11-29 First crack at a layout
    [Snack Machine.kicad_pcb, Snack Machine.sch, USB_Serial.sch, motor_power.sch]
2018-12-02 Way too much work to accurately describe in a commit message
    [Snack Machine.kicad_pcb, Snack Machine.sch, USB_Serial.sch, motor_power.sch]
2018-12-02 Added Ethernet jack
    [Ethernet.sch, Snack Machine.kicad_pcb, Snack Machine.sch, USB_Serial.sch]
2018-12-02 Pushing up current changes
    [Ethernet.sch, Snack Machine.kicad_pcb]
2018-12-02 Placing every non test point component I have
    [Snack Machine.kicad_pcb]
2018-12-11 added parts for Y3, FB2, FB3, F1
    [Ethernet.sch, Snack Machine.sch, USB_Serial.sch, motor_power.sch]
2018-12-11 added note about MDB needing opto-isolation
    [Snack Machine.sch]
2018-12-19 Changed the power diodes to Schottky
    [Ethernet.sch, Snack Machine.sch, USB_Serial.sch, motor_power.sch]
2018-12-20 Fixing small issue with a missing $EndComp
    [Snack Machine.sch]
2018-12-20 removed D1 and D3, left Schottky diodes alone
    [Snack Machine.sch, USB_Serial.sch]
2018-12-20 fixed schematic rules check, generated netlist
    [Ethernet.sch]
2018-12-20 tweaked ethernet
    [Ethernet.sch, Snack Machine.sch, USB_Serial.sch]
2018-12-20 added footprints for Y3 FB1 FB3 FB2 F1
    [Ethernet.sch, Snack Machine.sch, USB_Serial.sch]
2018-12-20 created footprint for USB micro, linked to J16
    [USB_Serial.sch]
2018-12-20 fixed W5500 schematic part
2018-12-22 updated motor drive circuitry, annotated
    [Ethernet.sch, Snack Machine.kicad_pcb, Snack Machine.sch, USB_Serial.sch, motor_power.sch]
2018-12-22 fixed S2A and motor drive capacitor footprint links
    [Snack Machine.sch, USB_Serial.sch, motor_power.sch]
2018-12-22 imported netlist
    [Snack Machine.kicad_pcb]
2018-12-28 changed footprints for SMB and SOT-23 so the handsoldering is more reasonable
2018-12-28 Updated Schematic
    [Snack Machine.sch, motor_power.sch]
2018-12-28 changed footprint for TSOT23 handsoldering to be more reasonable
    [Snack Machine.kicad_pcb, motor_power.sch]
2018-12-28 added one resistor, about to rip up all traces and move all the parts around
    [Ethernet.sch, Snack Machine.kicad_pcb]
2018-12-28 rearranging footprints on layout
    [Snack Machine.kicad_pcb, Snack Machine.sch, USB_Serial.sch]
2018-12-28 moving stuff around
    [Ethernet.sch, Snack Machine.kicad_pcb, Snack Machine.sch]
2018-12-28 Moved stuff around on the layout, still need to fanout the large processor, place the power regulators, place the door switch connector, place the RFID connectors, and place the LCD connectors. Once 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
    [Snack Machine.kicad_pcb]
2018-12-31 all parts placed within board outline
    [Snack Machine.kicad_pcb]
2018-12-31 some routing complete
    [Snack Machine.kicad_pcb]
2019-01-01 routed some more
    [Snack Machine.kicad_pcb]
2019-01-01 pushing stuff around, routing more
    [Snack Machine.kicad_pcb]
2019-01-04 added additional LCD reset circuitry and swapped LCD TX and RX
    [Ethernet.sch, Snack Machine.sch]
2019-01-04 changed SW1 footprint, generated netlist
    [Snack Machine.sch]
2019-01-05 all nets routed, reference designators aligned
    [Snack Machine.kicad_pcb, Snack Machine.sch]
2019-01-05 added courtyards to footprints missing them
    [Snack Machine.kicad_pcb]
2019-01-08 added BOM first draft
    [Snack Machine BOM.ods]
2019-01-08 cleaned up jpeg and lock files that were mistakenly added to git, generated bom
    [Snack Machine BOM.ods]
2019-01-15 starting new branch to whack ethernet, replace with ESP32
    [Snack Machine BOM - denhac.ods]
2019-01-15 BOM update
    [Snack Machine BOM - denhac.ods]
2019-01-15 Removing CSV exemption from .gitignore
    [Snack Machine BOM - denhac.csv, Snack Machine BOM - octopart.csv]
2019-01-15 changed C1 to 0805
    [Snack Machine.sch]
2019-01-22 removed ethernet, added huzzah32
    [Snack Machine.sch, USB_Serial.sch, motor_power.sch]
2019-01-24 Added ESP32 Huzzah module and logic level converters. Looks like TX and RX need to be checked for all UARTs on ATmega2560. Also, some of the Q and R reference designators reverted to ? in the motor d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
    [Snack Machine.sch, USB_Serial.sch, motor_power.sch]
2019-01-25 Trying to fix label errors
    [motor_power.sch]
2019-01-25 Annotating remaining power symbols
    [Snack Machine.sch]
2019-01-26 Adding HUZZAH32 footprint
    [Snack Machine.sch]
2019-01-26 Fixing footprint and schematic symbol for the huzzah32
2019-02-01 fixed UARTs on Mega2560
    [Snack Machine.sch]
2019-02-01 imported new netlist
    [Snack Machine.kicad_pcb]
2019-02-01 I think all traces are routed, about to run DRC
    [Snack Machine.kicad_pcb]
2019-02-01 pushed a couple of reference designators, fixed copper pours
    [Snack Machine.kicad_pcb]
2019-02-01 created gerbers
    [Snack Machine-B.Cu.gbr, Snack Machine-B.Mask.gbr, Snack Machine-B.Paste.gbr, Snack Machine-B.SilkS.gbr, Snack Machine-Edge.Cuts.gbr, Snack Machine-F.Cu.gbr, Snack Machine-F.Mask.gbr, Snack Machine-F.Paste.gbr]
2019-02-03 Updating a ton of part numbers
    [Snack Machine.sch, USB_Serial.sch, motor_power.sch]
2019-02-03 Fixing small typo
    [motor_power.sch]
2019-02-04 fixed a few small issues
    [Snack Machine-B.Cu.gbr, Snack Machine-B.Mask.gbr, Snack Machine-B.Paste.gbr, Snack Machine-B.SilkS.gbr, Snack Machine-Edge.Cuts.gbr, Snack Machine-F.Cu.gbr, Snack Machine-F.Mask.gbr, Snack Machine-F.Paste.gbr]
2019-02-27 Basic framework for multiple configs
2019-02-27 Trying to get the motors to work
2019-12-09 Making a bunch of changes throughout the board
    [Huzzah32.sch, Snack Machine.sch, USB_Serial.sch, motor_power.sch]
2019-12-09 Combining RFID to 1 header and improving 4D LCD stuff
    [4D_Display.sch, Huzzah32.sch, Snack Machine.sch, USB_Serial.sch, motor_power.sch]
2019-12-09 Fixing ERC rules
    [4D_Display.sch, Huzzah32.sch, Snack Machine.sch, USB_Serial.sch, motor_power.sch]
2019-12-09 Missing annotations
    [Huzzah32.sch, USB_Serial.sch]
2019-12-09 Current WIP for board layout
    [4D_Display.sch, Huzzah32.sch, Snack Machine.kicad_pcb, Snack Machine.sch, USB_Serial.sch, motor_power.sch]
2019-12-09 Committing before changing schematic
    [Snack Machine.kicad_pcb]
2019-12-09 Rotated serial ports around to make routing easier
    [4D_Display.sch, Huzzah32.sch, Snack Machine.sch, USB_Serial.sch]
2019-12-09 Unrouted is 0! Woot!
    [Snack Machine.kicad_pcb, Snack Machine.sch]
2019-12-09 Saving current progress
    [Snack Machine.kicad_pcb]
2019-12-09 Sourcing parts
    [Snack Machine.kicad_pcb, Snack Machine.sch, USB_Serial.sch, motor_power.sch]
2019-12-09 Adding source to SilkScreen
    [Snack Machine.kicad_pcb]
2019-12-10 Fixing some small issues here and there
    [Snack Machine-B.Cu.gbr, Snack Machine-B.Mask.gbr, Snack Machine-B.Paste.gbr, Snack Machine-B.SilkS.gbr, Snack Machine-B_Cu.gbr, Snack Machine-B_Mask.gbr, Snack Machine-B_Paste.gbr, Snack Machine-B_SilkS.gbr]
2019-12-31 Added part number, manufacturer, and personal bin numbers
    [4D_Display.sch, Huzzah32.sch, Snack Machine.sch, USB_Serial.sch, motor_power.sch]
2019-12-31 Switching to Eventually for event management
2019-12-31 Committing current progress on RFID work
2020-02-09 Getting motors to start turning
2020-03-09 Making some board modifications for the final revision
    [Snack Machine.kicad_pcb, Snack Machine.sch, motor_power.sch]
2020-04-09 Updating board to remove EXP1/EXP2
    [4D_Display.sch, Huzzah32.sch, Snack Machine.kicad_pcb, Snack Machine.sch]
2020-04-09 Fixing the +5V trace
    [Snack Machine.kicad_pcb]
2020-04-09 Improving some grounding issues
    [Snack Machine.kicad_pcb, USB_Serial.sch]
2020-05-02 Committing changes to the circuit board
    [Snack Machine-B_Cu.gbr, Snack Machine-B_Mask.gbr, Snack Machine-B_Paste.gbr, Snack Machine-B_SilkS.gbr, Snack Machine-Edge_Cuts.gbr, Snack Machine-F_Cu.gbr, Snack Machine-F_Mask.gbr, Snack Machine-F_Paste.gbr]
2020-05-02 Committing current progress
2020-05-27 Fixing a couple of small issues
    [CoinChanger.cpp, CoinChanger.h, MDB.cpp, MDB.h]
2020-07-11 Adding code to control motors
2020-07-11 Fixing a couple of issues I noticed
    [motors.cpp, motors.h]
2020-07-14 Saving current MDB progress to refactor out new
2020-07-26 Bringing all hardware online at the same time
    - Had to fix some timing issues in this diff
    [DenhacBoard.cpp, DenhacBoard.h, Looper.cpp]
2020-07-26 Refactored Motors functionality to work with loop idea
2020-07-27 Cleaning up UI and Bindings access
    Basically the goal here is to make it easier to access things in a clean way. The Denhac UI struct helps keep instances of all of the window classes so that any window can access any other in a static way. DenhacBindings provides a cleaner way (at least from the context of the DenhacBoard class) to bind all of the callbacks to where they need to go.
    [DenhacBindings.cpp, DenhacBindings.h, DenhacBoard.cpp, DenhacBoard.h]
2020-07-29 Adding watchdog timer and fun MainWindow test
2020-07-31 Switched draw -> show and added hiding Window method
2020-07-31 Fixing motors scan code
    [DenhacBoard.cpp, motors.cpp]
2020-08-01 Added some buttons for the letters and numbers
2020-08-01 Buttons now can update on pressed state
2020-08-01 Fixing some issues with the API and with compiling the wifi bridge
    [BootWindow.cpp, DenhacBindings.cpp, DenhacWifiBridge.cpp, DenhacWifiBridge.h, MainWindow.cpp, Session.cpp, SiteLink.cpp]
2020-08-01 Fixing some wifi bridge issues
    [DenhacBoard.cpp, DenhacWifiBridge.cpp, ProductManager.cpp, SiteLink.cpp, SiteLink.h]
2020-08-01 Products update correctly now
    If the machine was off when a product was updated, it didn't get
    notified that the product was no longer at a certain row/col so the
    EEPROM for that location still looked valid. Now we remove all
    products that weren't in the first product update.
    [MainWindow.cpp, MainWindow.h, ProductManager.cpp, ProductManager.h, SiteLink.cpp]
2020-08-01 Small fix in SiteLink
    I thought I could make it handle the reset slightly faster but
    lowering how many loops it took to cause a reset meant it would
    reset infinitely.
    [SiteLink.cpp]
2020-08-01 Session now has current order
2020-08-01 User can select row/col to add product to current order
2020-08-02 Fixing text color issue
    [MainWindow.cpp]
2020-08-02 Added Cancel Button
2020-08-02 Cancel order button gets called on money inserted
2020-08-02 Improving look of cancel order button a little
2020-08-02 Added "Add Item" button
2020-08-02 Clicking "Cancel Order" resets current session
    [MainWindow.cpp, Order.cpp, Order.h, Session.cpp, Session.h]
2020-08-03 Added Vend Button
2020-08-03 Started with Membership Button
2020-08-03 Added MembershipButtonState for the membership button
2020-08-03 Membership Button now shows orders available for pickup
2020-08-03 Fixing small issue with Membership Button
    [MainWindow.cpp]
2020-08-03 Wifi Bridge now waits for an ACK from the host side
    The Arduino buffer is only 64 bytes, so we could do a normal product update
    and completely trash the buffer. A single product is pretty close to 64 bytes
    anyway. We still need to check that the max product sent isn't longer than
    64 bytes when sent with msgpack
2020-08-03 Removed "resetSent" from SiteLink
    I thought that would improve the site link to have that, but it just
    makes it so if the first reset doesn't work that it can never reset
    again. I had it to prevent infinite reset loops, but that seems far
    less common.
    [SiteLink.cpp, SiteLink.h]
2020-08-03 SiteLink now correctly grabs order status
    [Order.cpp, Order.h, SiteLink.cpp]
2020-08-03 disabling vend button if session is reset
    [MainWindow.cpp]
2020-08-03 Trying to fix/improve button management in MainWindow
    [MainWindow.cpp, MainWindow.h, Session.cpp, Session.h]
2020-08-03 Handling unknown card scan
    Also changed the colors of the vend button around so it's more
    visible when you can vend
2020-08-05 Improving SiteLink protocol slightly
    This diff does two things. First we reduce the size of a product update
    by shortening the max length of the name. This ensures that the max product
    packet length is 63 bytes.
    The second thing it does is not send product updates unless the host requests
    it. This is to work around some of the issues with ACKing packets.
    [DenhacWifiBridge.cpp, DenhacWifiBridge.h]
2020-08-05 Adjusting how ACKs work for fetching orders
    This is to help prevent buffer overflowing and will be one of several
    diffs like it. The basic concept is, if the next piece of the packet,
    whether it's the order header, item, etc. would overflow the buffer,
    then we wait for an ACK from the other side. Both sides use the same
    math so the ACK and wait for ACK on the same schedule.
    [DenhacWifiBridge.cpp, DenhacWifiBridge.h, MaxPacketSize.h]
2020-08-06 Update order now sends ACK at the correct times
    [DenhacWifiBridge.cpp, DenhacWifiBridge.h, MaxPacketSize.h]
2020-08-06 Bumped the Bridge speed back up to 115200
    We lowered it to 9600 to reduce the chance of buffer overflows but
    now that we're removing the possibility of buffer overflows from
    the code itself, it doesn't really mater what speed we send it at.
    The only possible concern is bit errors, but I have no error checking
    and for now I'm mostly just hoping for the best :)
    [DenhacWifiBridge.cpp]
2020-08-06 Get order for SiteLink sends ACKs correctly now
    [DenhacWifiBridge.cpp, Session.cpp, SiteLink.cpp, SiteLink.h]
2020-08-06 Added Order Cancelled function to SiteLink
    I had to fix the WiFi bridge too because the cancel endpoint doesn't
    return a body so the JSON decoding fails. Now the bridge grabs the
    content length from the response in the event we ever need that again.
    If we need to grab more of these things from the API endpoint, we should
    look into regex somehow.
    Next up is the last existing endpoint which is the "update order" one.
    Primarily this will be used to verify someone really can vend what they
    want AND to update vended amounts after the vend itself has kicked off.
    [DenhacWifiBridge.cpp, RestRequest.cpp, RestRequest.h, SiteLink.cpp, SiteLink.h]
2020-08-06 Removed a bunch of print statements
2020-08-06 Added "Update Order" endpoint
    No idea of it works currently. I'll need to build out some test data
    for it and then test it, so this may not work 100% but we'll see.
    [Order.cpp, Order.h, SiteLink.cpp, SiteLink.h]
2020-08-06 Add Item button should be disabled for "processing" order status
2020-08-06 Inverted the colors on the main window buttons
    I originally made the buttons have the color border and the white
    background when not pressed and then switched to one solid color
    with white text when pressed. This diff inverts that.
    If someone is colorblind then the enabled not-pressed button and
    the disabled button would look basically the same. Plus this
    honestly just looks better with the pressed action. In real life
    you would think of a button being pushed down and this gives a
    similar effect without the use of shadows.
    I did modify the row/col buttons here but they don't match that
    pattern. I did that for two reasons. One is that when it's a solid
    background, it tends to be overpowerin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
    [MainWindow.cpp]
2020-08-06 Vend button is enabled if there is enough money available to vend
2020-08-06 Full vend functionality works
    It's very basic and doesn't handle corner cases, but it was very
    cool to watch the order update to the 'processing' status and then
    update to the 'vending' status.
    I still haven't done this with it all installed in the machine, so
    no idea if it actually turns the motors with this version. We've
    made some heavy modifications to that class since the last test.
    [Session.cpp, Session.h]
2020-09-24 Fixing a couple of small timing issues
    [SiteLink.cpp, SiteLink.h, motors.cpp, utils.h]
2020-09-24 Reset session if new card is scanned
    [Session.cpp]
2020-09-24 Fixed a couple of corner cases around change management
    [Session.cpp, SiteLink.cpp]
2020-09-25 Fixing a couple of small bugs
    [MainWindow.cpp, Session.cpp]
2020-10-17 Fixing a couple of small issues that have been found
    - The screen wasn't clearing everything if you had too many items on screen
    - Sometimes things like card scanning and product updates stopped working.
    Best guess is the two boards got out of sync so now the main board sends a
    reset on the secondary board if it's not safe to send from the main board's
    perspective but the huzzah32 hasn't responded yet
    [MainWindow.cpp, SiteLink.cpp, SiteLink.h]
2021-02-07 untracked files on rev4: f443c88 Preventing vend issue with last item available
    [4D_Display.kicad_sch, MDB.kicad_sch, MDB.sch, Snack Machine.kicad_sch, motor_power.kicad_sch]
2021-02-07 Fixed invalid product being added/vended
    [MainWindow.cpp, Order.cpp, Order.h, Product.cpp, Product.h, ProductManager.cpp, Session.cpp]
2021-02-11 Automatically reset the board in case of issues
    [BootWindow.cpp, MainWindow.cpp]
2021-02-11 Revert "untracked files on rev4: f443c88 Preventing vend issue with last item available"
    This reverts commit 96ae08953e1a785916d74f2d1b476cea8e7f1401.
    [4D_Display.kicad_sch, MDB.kicad_sch, MDB.sch, Snack Machine.kicad_sch, motor_power.kicad_sch]
2021-02-18 Fixing bug with exact change
    [Session.cpp]
2021-02-18 Preventing vend issue with last item available
    [MainWindow.cpp, ProductManager.cpp, ProductManager.h]
2023-01-16 Preventing copy overwriting reset order
    [Session.cpp]
2023-01-19 Small changes to remove unused code / fix comments
    [DenhacBoard.cpp, SiteLink.cpp, SiteLink.h]
2023-01-30 Removed GizmoDojo config since they no longer have a vending machine
    [vendingMachine.cpp]
2023-01-30 Fixing issue with SiteLinkCommand coppy constructor
    [SiteLink.cpp, SiteLink.h]
2023-01-30 Improving buttons and "no orders" state
2023-01-30 Adding items is limited by what's in the current order
2023-01-30 Shorter boot timeout and faster baud rate
    [BootWindow.cpp]
2023-03-04 Moving Main Board down one level
    [4D_Display.sch, Ethernet.sch, Huzzah32.sch, Snack Machine BOM - denhac.csv, Snack Machine BOM - denhac.ods, Snack Machine BOM - octopart.csv, Snack Machine BOM.ods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]
2024-09-15 Updated upload port for esp32i
2024-09-15 Fixed progress bar being written to a different location
    [BootWindow.cpp]
2026-05-26 Fixed coin changer idle setup
    [BootWindow.cpp]
